emrahyalcin23/picolor/power_circuit.png

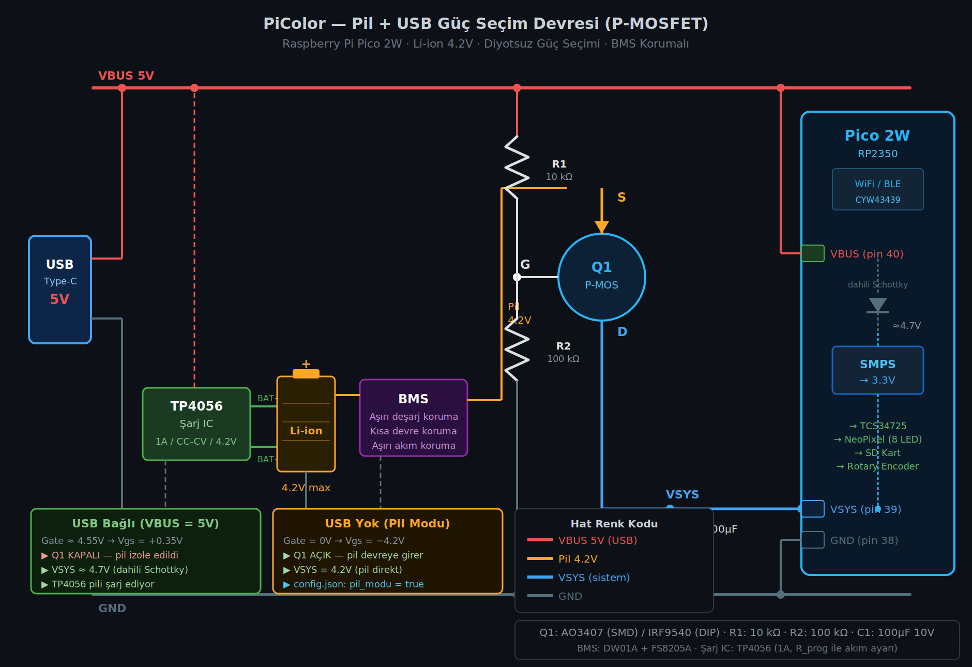
power_circuit.png
