emrahyalcin23/picolor/(commit log)

2026-05-14 feat: merkezi ondalık basamak ve Weber-Fechner logaritmik ölçek desteği
    İşlenmiş RGB çıktıları için `outputDecimals` değişkeni ile basamak sayısı
    merkezi olarak kontrol edilebilir hale getirildi (varsayılan: 1, geriye
    uyumlu). `applyOutputScale()` ile Weber-Fechner (fotometrik standart)
    logaritmik dönüşüm eklendi; bu dönüşüm varsayılan olarak kapalıdır.
    Yeni komutlar:
    - BASAMAK_<n> : ondalık basamak (0–6)
    - LOGARITMIK : log ölçeği aç (mevcut dekad)
    - LOGARITMIK_<n> : log ölçeği aç + dekad ayarla (1.0–5.0)
    - LINEER : lineer ölçeğe dön
    - VARSAYILAN/DEFAULT: fabrika ayarlarına dön (decimals=1, lineer)
    - OLCEK/SCALE : me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
2026-05-14 fix: RP2040 SPI.begin() API uyumsuzluğunu düzelt
    ESP32 tarzı SPI.begin(sck, miso, mosi, cs) çağrısı RP2040'ta desteklenmiyor.
    RP2040'ın SPIClassRP2040 API'sine uygun setRX/setTX/setSCK/setCS + begin()
    sırasına geçildi.
    https://claude.ai/code/session_01SwauKkrZt6LshzN8axL5hw
    [PiColor.ino]
2026-05-27 feat(d6): WiFi AP+STA + TCP soketi + BLE NUS kablosuz katmanı
    - WIRELESS_ENABLED / LOGGING_ENABLED özellik anahtarları eklendi
    - broadcastLine() ile tüm çıktılar Serial+TCP+BLE'ye çoğaltılır;
    Serial satırı değişmez, wireless satıra ;user=<username> eklenir
    - processCommandLine(line, username) ile TCP/BLE komut ayrıştırması
    handleSerialCommands() ile ortak kod yolu paylaşır
    - setupWiFi(): AP(PiColor) + STA dual mod, TCP:8266, picolor.local mDNS
    - setupBLE(): ArduinoBLE ile NUS (6E400001) servisi, TX notify + RX write
    - handleTCPClients() / handleBLEClients(): non-blocking loop entegrasyonu
    - USER:username prefix ile şifresiz kimlik etiketi desteği
    - WIRELESS_ENABLE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
2026-06-04 BLE katmanını ArduinoBLE'den BTstackLib'e geçir (Pico 2W uyumu)
    ArduinoBLE, Pico W/2W'nin CYW43439 yongasını desteklemiyor; arduino-pico
    core'un built-in BTstackLib'i ile değiştirildi. NUS UUID'leri, komut
    mantığı ve diğer tüm iletişim kanalları (WiFi, TCP, Serial) değişmedi.
    Bağlantı/bağlantı-kesme callback tabanlı; RX yazma olayları ana döngüden
    işleniyor (BTstack reentrancy sorunundan kaçınmak için).
    https://claude.ai/code/session_01VbD8HC3pcwUNz6DdSRJpcG
2026-06-16 Özellik anahtarlarını config.h'e, runtime ayarları SD config.txt'e taşı
    - config.h: WIRELESS_ENABLED, LOGGING_ENABLED derleme bayrakları +
    DEFAULT_* sabitleri + EEPROM flash yazma limiti uyarısı
    - config.txt: SD kartta kullanıcının düzenleyeceği key=value dosyası
    - PiColor.ino: loadSDConfig() boot'ta SD'den okur; kart/dosya yoksa
    DEFAULT_* değerleri korunur
    - WiFiServer pointer'a alındı (cfgTcpPort runtime'da belirleniyor)
    - WIFI_AP_SSID/PASS/TCP_PORT/LOG_FILE #define'ları cfg* değişkenleriyle değiştirildi
    https://claude.ai/code/session_01U3DkBfnZt8ahWiA8Nv8KkM
    [config.txt]
2026-06-16 Başlangıç koşullarını config.txt'den yükle, EEPROM uyarısını .ino'ya ekle
    - loadSDConfig(): basamak, logaritmik, log_dekad, mod, dual_cikti
    anahtarları eklendi — outputDecimals, logarithmicOutput, logDecades,
    calibMode, dualOutputActive boot'ta config'den okunur
    - EEPROM flash yazma limiti uyarısı EEPROM tanımlarının üstüne eklendi
    - config.txt yeni anahtarları ve açıklamalarını içerecek şekilde güncellendi
    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
    [config.txt]
2026-06-16 config.txt: her ayar için detaylı Türkçe açıklama ekle
    Weber-Fechner formülünün normal log'dan farkı, logaritmik mod,
    log_dekad oranları, STABIL/DINAMIK mod farkı açıklandı
    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
    [config.txt]
2026-06-16 platformio.ini ekle: PlatformIO için BT stack ve kütüphane ayarları
    Arduino IDE platformio.ini'yi yok sayar — iki araç birbirini etkilemez.
    PlatformIO'da ip_bluetooth_stack otomatik uygulanır, elle ayar gerekmez.
    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
2026-06-16 platformio.ini: platform, core ve kütüphane versiyonlarını kilitle
    - platform: maxgerhardt/platform-raspberrypi#v1.13.0 (tag sabitlendi)
    - platform_packages: arduino-pico core 3.9.4 (ikinci katman kilitleme)
    - lib_deps: ^ kaldırıldı, tam sürüm numaraları kullanıldı
    - Tekrarlanabilir build için politika yorumu eklendi
    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
2026-06-16 BLE API'yi BTstackLib yeni versiyonuyla uyumlu hale getir
    - BD_ADDR bleCentralAddr → hci_con_handle_t bleCentralHandle
    - device->getAddress() → device->getHandle()
    - BTstack.bleStartAdvertising() → BTstack.startAdvertising() (2 yerde)
    - onBLECharacteristicWrite: void(BLEDevice*,int,...) → int(uint16_t,...)
    - BTstack.sendNotification() → att_server_notify() (att_server.h eklendi)
    - Bağlantı kopunca bleCentralHandle HCI_CON_HANDLE_INVALID'e sıfırlanır
    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
2026-06-16 platformio.ini: arduino-pico core versiyonunu 5.6.0 olarak güncelle
    Derleme başarıyla doğrulandı: rp2040 5.6.0 ile BTstackLib
    yeni API'si (getHandle, startAdvertising, att_server_notify) çalışıyor.
    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
2026-06-16 DURUM komutu ekle, TCP sunucu timing sorununu düzelt
    - showDurum(): versiyon, SD, ölçek ayarları, WiFi AP IP/port, BLE durumu
    - DURUM / STATUS komutu processCommand ve YARDIM ekranına eklendi
    - softAP() sonrası IP atanana kadar bekle — TCP begin() öncesi timing fix
    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
    [PiColor.ino]
2026-06-16 WiFiServer pointer → global static, TCP bağlantı sorunu düzelt
    new WiFiServer() heap allocasyonu arduino-pico 5.6.0'da begin() ile
    çalışmıyor. Global static + begin(port) yaklaşımına dönüldü.
    Versiyon v0.06.04 → v0.06.05
    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
2026-06-16 TCP port compile-time sabite dönüştür, WiFiServer global static'e al
    WiFiServer(0).begin(port) arduino-pico 5.6.0'da çalışmıyor — port
    0 ile bağlanıp 8266'yı dinlemiyor. WiFiServer(DEFAULT_TCP_PORT) global
    static olarak tanımlandı, begin() parametresiz çağrılıyor.
    cfgTcpPort değişkeni ve tcp_port config okuma kaldırıldı.
    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
    [config.txt]
2026-06-16 feat(wifi): AP+STA çift mod — ev ağı entegrasyonu (v0.07.00)
    - setupWiFi: AP önce başlatılıyor, STA non-blocking sonra bağlanıyor
    (önceki sıra bazen AP'yi engelleyebiliyordu)
    - reconnectWiFiSTA: WiFi.disconnect() kaldırıldı — AP'yi kesmiyoruz
    - handleWiFiReconnect: loop'ta her 30s STA bağlantısını kontrol eder,
    kopmuşsa otomatik yeniden bağlanır
    - DURUM/STATUS: STA_IP satırı eklendi (ev ağı IP'si görünür hale geldi)
    - WIFI_BILGI: STA_IP ve AP_IP ayrı ayrı raporlanıyor
    - TCP sunucusu AP (192.168.42.1) ve STA (ev ağı IP) her ikisinde dinler
    Kullanım:
    WIFI_SSID=<ev_agi_adi> → EEPROM'a yaz
    WIFI_PASS=<sifre> → EEPROM'a yaz
    WIFI_BAGLAN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
2026-06-16 fix(config): SD karttan STA kimlik bilgisi okuma + öncelik sırası düzeltmesi (v0.07.01)
    Sorun: STA kimlik bilgileri yalnızca EEPROM'a yazılabiliyordu; her reset
    sonrasında Serial Monitor bağlantısı gerekliydi. config.txt'e wifi_sta_ssid /
    wifi_sta_pass eklenerek SD kart üzerinden dağıtım yapılabilir hale geldi.
    Sorun: setup() içinde loadSDConfig() EEPROM'dan ÖNCE çalışıyordu; bu yüzden
    EEPROM her zaman SD'yi eziyordu. Sıra düzeltildi:
    1. loadWiFiCredentials() — EEPROM (düşük öncelik)
    2. loadSDConfig() — SD kart (yüksek öncelik, EEPROM'u geçersiz kılar)
    Değişiklikler:
    - loadSDConfig(): wifi_sta_ssid / wifi_sta_pass anahtarları eklendi
    (y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
    [config.txt]
2026-06-16 feat(wifi): STA otomatik bağlantı bayrağı — DEFAULT_WIFI_STA_AUTO (v0.08.01)
    config.h: DEFAULT_WIFI_STA_AUTO = true (açılışta otomatik STA bağlantısı)
    config.txt: wifi_sta_otomatik=true/false anahtarı eklendi
    PiColor.ino: cfgWifiStaAuto değişkeni; setupWiFi ve handleWiFiReconnect
    bu bayrağı kontrol ediyor — false ise yalnızca WIFI_STA_BAGLAN ile bağlanır
    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
    [config.txt]
2026-06-16 refactor(config): config.h sadeleştirildi, varsayılanlar .ino'ya taşındı (v0.08.02)
    config.h artık yalnızca derleme zamanı sabitleri içeriyor (4 satır):
    WIRELESS_ENABLED, LOGGING_ENABLED, MAX_TCP_CLIENTS, DEFAULT_TCP_PORT
    DEFAULT_WIFI_AP_SSID / PASS / STA_AUTO / LOG_FILE kaldırıldı;
    değerleri PiColor.ino içinde cfgWifiApSSID vb. başlangıç değerleri olarak taşındı.
    Kullanıcı yalnızca config.txt'e bakması yeterli; config.h nadiren değişir.
    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
2026-06-16 refactor: JSON config, WiFiServer pointer, #if guardları kaldırıldı (v0.09.00)
    [config.txt]
2026-06-16 fix: STA_IP display bug, TCP_PORT= runtime komutu, changeTcpPort() (v0.09.01)
    - showDurum(): strlen(wifiStaSSID) > 0 kontrolü eklendi — SSID boşken
    WiFi.status()==WL_CONNECTED yanlış pozitif veriyordu (CYW43 AP mode quirk)
    - changeTcpPort(): stop→delete→new→begin döngüsüyle runtime port değişimi
    - processCommandLine(): TCP_PORT=<n> komutu eklendi
    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
    [PiColor.ino]
2026-06-16 fix(tcp): WiFiServer global nesne kullan — begin() arduino-pico'da güvenilir çalışsın (v0.09.02)
    new WiFiServer() heap alloc + begin() arduino-pico 5.6.0'da tcp listener
    oluşturmuyor (actively refused). Standart pattern: global nesne + begin().
    - g_tcpServer(DEFAULT_TCP_PORT) global eklendi
    - setupWiFi(): &g_tcpServer ile başlat, cfgTcpPort farklıysa changeTcpPort()
    - changeTcpPort(): global vs heap ayrımı — global nesneyi delete etme
    - #define DEFAULT_TCP_PORT 8266 eklendi (config.h silindikten sonra eksikti)
    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
    [PiColor.ino]
2026-06-16 feat: WIRELESS_ENABLED komutu, LittleFS config.json desteği (v0.09.03)
    - WIRELESS_ENABLED=0/1 (veya OFF/ON, FALSE/TRUE): oturum bazlı WiFi
    açma/kapama; disableWiFi() + enableWiFi() fonksiyonları eklendi
    - LittleFS desteği: SD kart yoksa Pico kendi flash'ından /config.json okur
    Öncelik: SD kart > LittleFS > hardcoded default
    - data/config.json: "Upload Filesystem Image" ile LittleFS'e yazılacak şablon
    - platformio.ini: board_build.filesystem_size = 256k eklendi
    - handleTCPClients / handleWiFiReconnect: !wifiEnabled guard eklendi
    - setupWiFi: MDNS.begin() çift çağrıya karşı static flag koruması
    - Versiyon v0.09.03
    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
2026-06-16 chore: platformio.ini kaldırıldı — proje Arduino IDE ile yönetilecek
    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
2026-06-16 fix: DEFAULT_WIFI_STA_SSID/PASS eklendi — ev modemi bilgisi en tepede görünür
    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
    [PiColor.ino]
2026-06-16 fix: loadWiFiCredentials — EEPROM boşsa default değeri silme
    EEPROM'da kayıt yokken wifiStaSSID[0]='\0' yapılıyordu, DEFAULT_WIFI_STA_SSID
    değeri yok sayılıyordu. Artık EEPROM boşsa default korunuyor.
    Öncelik sırası: config.json (SD) > EEPROM > DEFAULT_WIFI_STA_SSID (.ino)
    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
    [PiColor.ino]
2026-06-16 fix: WIFI_STA_SIFIRLA anında default'a döner ve bağlanmayı dener
    clearWiFiCredentials(): EEPROM silindikten sonra wifiStaSSID/Pass'ı
    DEFAULT_WIFI_STA_SSID/PASS ile restore et, ardından reconnectWiFiSTA()
    ile hemen bağlantı denemesi başlat. DEFAULT boşsa NO_CREDENTIALS döner.
    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
    [PiColor.ino]
2026-06-16 fix: softAPConfig kaldırıldı — CYW43 5.6.0'da AP IP'siz kalıyordu
    softAPConfig(192.168.42.1) arduino-pico 5.6.0 CYW43 driver'ında
    uygulanmıyor, AP_IP=(IP unset) sonucunu veriyordu. Kaldırıldı;
    AP default 192.168.4.1 kullanır.
    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
    [PiColor.ino]
2026-06-16 fix: AP_IP display fallback + TCP_CLIENT_CONNECTED user=tcp (v0.09.04)
    - apIPStr(): softAPIP() 0.0.0.0 dönerse 192.168.4.1 göster (CYW43 quirk)
    - TCP bağlantı anında currentUsername="tcp" — user=serial yerine user=tcp
    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
    [PiColor.ino]
2026-06-16 revert: apIPStr() kaldırıldı — WIRELESS_ENABLED=0 durumunda yanlış IP gösteriyordu
    AP durduğunda softAPIP() 0.0.0.0 dönmesi doğru davranış.
    Hardcoded fallback yanıltıcıydı.
    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
    [PiColor.ino]
2026-06-17 test: --all bayrağı ve DURUM'dan otomatik IP keşfi eklendi
    - --all: Serial → WiFi → BLE sırasıyla tüm kanalları çalıştırır
    - --ip verilmezse Serial bağlantısı üzerinden WIFI_BILGI/DURUM
    sorgulanarak AP IP otomatik çekilir; bulunamazsa 192.168.42.1 kullanılır
    - ip_from_durum(): AP IP öncelikli, STA IP yedek, genel IPv4 son çare
    - WiFi bağlantı çıktısında IP'nin kaynağı gösterilir (--ip / DURUM / varsayılan)
    Claude-Session: https://claude.ai/code/session_01H9rqM9a2WAjiGBZZuHZdFa
2026-06-17 docs: README baştan yeniden yazıldı (v0.09.04)
    Eski README güncel değildi (yanlış NORM_INPUT_MAX, WiFi/BLE yok).
    Yeni README:
    - AP+STA çift mod WiFi, mDNS, TCP port yapılandırması
    - BLE Nordic UART Service UUID'leri
    - Çıktı protokolü tam tip/mod tablosu, DUAL format
    - STABIL/DINAMIK kalibrasyon formülleri ve encoder kullanımı
    - Weber-Fechner log ölçeği açıklaması
    - config.json öncelik sırası + EEPROM + derleme sabitleri
    - Tam komut referansı (tüm kategoriler)
    - RAM tamponu ve SD kart depolama detayları
    - EN + TR tam çift dil
    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
2026-06-17 fix: prevent Serial.println() from blocking when no USB host is connected
    Without a USB host (e.g. 5V charger), the CDC TX buffer fills up and
    Serial.println() blocks indefinitely, freezing the main loop and making
    the encoder and LEDs unresponsive. Guard the call with `if (Serial)`.
    Claude-Session: https://claude.ai/code/session_01MzXoiq43XPTvuBu1bNvTpt
    [PiColor.ino]
2026-06-18 fix: use availableForWrite() guard and Serial host check to prevent USB CDC blocking
    Two changes:
    1. broadcastLine(): replace `if (Serial)` with `availableForWrite()` check — works
    across all arduino-pico versions regardless of how operator bool() is implemented.
    When no USB host is present the CDC TX buffer fills and never drains; checking
    available space before writing prevents the infinite busy-wait inside Serial.write().
    2. handleSerialCommands(): add `!Serial` guard before readStringUntil() — some chargers
    drive D+/D- lines (Apple charging spec) which can trigger spurious Serial.available()
    reads; without a host check this causes a 1-second timeout per loop iteration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
    [PiColor.ino]
2026-06-18 fix: move Serial.begin() after setupWiFi/BLE to prevent CYW43 init failure
    Root cause: Serial.begin() starts TinyUSB which, with no USB host connected
    (5V charger), enters a continuous attach-retry loop generating high-frequency
    USB IRQs. These IRQs interfere with the CYW43439 SPI initialization, causing
    WiFi.softAP() to fail silently and the while(softAPIP()==0) guard loop to
    spin forever. setup() never completes, loop() never starts.
    Fix: initialize CYW43 (WiFi + BLE) before starting USB Serial so the chip
    comes up cleanly regardless of whether a USB host is present.
    Claude-Session: https://claude.ai/code/session_01MzXoiq43XPTvuBu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
    [PiColor.ino]
2026-06-18 debug: add TCS LED blink markers throughout setup() to find hang point
    Blink count indicates last completed step before device freezes.
    Remove dbgBlink() calls once root cause is identified.
    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
2026-06-18 fix: move Serial.begin() after WiFi/BLE init to prevent charger boot hang
    Root cause (confirmed via LED blink diagnostics): arduino-pico's USB CDC
    stack blocks inside Serial.begin() until a USB host enumerates the device.
    With a 5V charger (no USB host) this wait is infinite — setup() never
    completes, WiFi AP never starts, encoder never responds.
    Fix: remove Serial.begin() from the top of setup(). Call it only after
    setupWiFi() and setupBLE() have already succeeded. Add a 3-second timeout
    so the USB wait does not block indefinitely when no host is present.
    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
    [PiColor.ino]
2026-06-18 fix: add 15s timeout to softAPIP() busy-wait in setupWiFi and restartAP
    Without a timeout, setup() hangs forever if CYW43 takes too long or
    fails to assign the AP IP — blocking WiFi AP start on 5V charger.
    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
    [PiColor.ino]
2026-06-18 fix: skip STA connect when AP IP unset to prevent WiFi.begin() disrupting AP
    In arduino-pico 5.6.0, calling WiFi.begin() (STA) can interfere with
    an active softAP. Guard: only attempt STA connection when AP has a valid
    IP, ensuring the AP is fully up before STA is started.
    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
    [PiColor.ino]
2026-06-18 debug: NeoPixel renk markörleriyle setup() adım tanılaması
    Her adımda pixel-0 farklı renk — şarj başlığında takılı kaldığı
    yerde o renk sabit kalır. Test sonrası kaldırılacak.
    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
2026-06-18 debug: ham GPIO blink ile adım tanılaması (NeoPixel yok, sadece digitalWrite)
    N blink = N. adıma kadar ulaşıldı. 1 blink bile yoksa sorun
    framework init'te (setup() öncesi).
    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
2026-06-18 fix: serialReady flag ile Serial.begin() öncesi Serial erişimini engelle
    TinyUSB ile Serial.availableForWrite() Serial.begin() çağrılmadan
    önce bloke oluyordu. serialReady=false başlangıçta, Serial.begin()
    sonrasında true olur — broadcastLine() bu flag'i kontrol eder.
    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
    [PiColor.ino]
2026-06-18 debug: Wire.begin/tcs.begin arasina blink ekle, adim1=5 blink
    5 blink = setup() calisiyor (sensor farkindan ayirt eder).
    Wire.begin() sonrasi 2 blink, tcs.begin() sonrasi 3 blink.
    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
2026-06-18 fix: initVariant() override ile pre-setup() USB host beklemesini engelle
    arduino-pico weak tanimli initVariant()'i override ederek charger'da
    setup()'tan once gerceklesen USB host bekleme blogu kaldirildi.
    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
    [PiColor.ino]
2026-06-18 debug: global constructor probe (7 blinks) - main()/initVariant() oncesi
2026-06-18 debug: EarlyProbe duzeltme — RP2350 icin pico SDK gpio+timer kullan (busy_wait_ms)
2026-06-19 fix: No USB modu icin Serial guardi + serial_compat.h (USB-C sarj uyumlulugu)
    [PiColor.ino, serial_compat.h]
2026-06-19 fix: SerialUSBStub — No USB modunda SdFat linker hatalarini gider
    PioSdioCard.cpp (kullanilmayan SDIO surucu) Serial sembolune referans verir.
    No USB modunda SerialUSB derlenmediginden linker hata verir.
    Mangiled C++ sembolleri extern "C" ile stub olarak saglanir; char Serial[256]
    linker icin global nesneyi karsilar.
    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
    [SerialUSBStub.cpp]
2026-06-19 fix: cift sifirlama BOOTSEL'i devre disi birak (Apple 20W uyumlulugu)
    Apple 20W USB-C sarj basligi baglanti aninda VBUS'ta kisaca duser,
    RP2350 anlik sifirlanir. arduino-pico'nun cift-sifirlama=BOOTSEL ozelligi
    tetiklenince cihaz USB mass storage moduna girer, kullanici kodu
    hic calismaz. SKIP_DOUBLE_TAP bunu engeller.
    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
2026-06-19 refactor: debug kodu kaldir, NeoPixel boot LED ekle, RP2040→RP2350
    - _EarlyProbe ve _dbg() tamamen kaldırıldı
    - tcs.begin() hata/başarı mesajları geri eklendi
    - Boot tamamlanınca: R→G→B (3x100ms) blink
    - STA bağlanırken: kırmızı LED; bağlanınca: 1sn yeşil LED
    - RP2040 → RP2350 (PiColor.ino ve README.md)
    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
2026-06-19 docs: Arduino IDE ayarlarini ino basligina ekle
    Board, USB Stack (No USB), IP Stack (IPv4 Only), Flash Size,
    Upload Method ve Debug Level ayarlari aciklama ve gerekce ile
    belgelendi.
    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
2026-06-19 docs: IP Stack ayarini duzelt — IPv4+IPv6+Bluetooth
    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
2026-06-19 fix: STA kirmizi LED setupWiFi icinde WiFi.begin ile goster
    WiFi cok hizli baglandiginda RGB blink sirasinda zaten WL_CONNECTED
    oluyordu; kirmizi hic gorunmuyordu. WiFi.begin() ile ayni anda
    kirmizi LED yakilarak kullanicinin her durumda gorebilmesi saglandi.
    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
    [PiColor.ino]
2026-06-19 docs: add connection priority section and fix AP IP in README
    - Add 'Connection Channel Priority' section (EN + TR) with recommended
    order: WiFi AP → WiFi STA → BLE → COM
    - Note that COM/USB Serial is disabled in current No USB build and how
    to re-enable with TinyUSB; clarify Apple 20W issue is stack-agnostic
    - Add expected startup time note (~50-70 s) with LED indicator description
    - Fix AP IP in both EN and TR tables: 192.168.42.1 → 192.168.4.1
    (softAPConfig doesn't work in arduino-pico 5.6.0; AP always uses default)
    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
2026-06-19 fix: unify Serial init and correct TCS LED polarity
    - Move Serial.begin() to first line of setup() so all status messages
    in setupWiFi()/setupBLE() reach the serial port in both modes;
    only the 3 s USB CDC wait stays inside #if USE_TINYUSB
    - Set serialReady = true unconditionally after Serial.begin() —
    previously it was never set in No USB mode so UART output was silently
    dropped
    - Remove #if USE_TINYUSB guard from broadcastLine() — Serial now works
    the same way in both modes, no conditional needed
    - Fix TCS LED polarity bug: digitalWrite(TCS_LED_PIN, LOW) on an
    active-LOW pin turns the LED ON; change to HIGH so it is actually
    off at startup as the comment stated
    Co-Author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
    [PiColor.ino]
2026-06-20 fix: remove updateLEDs() from setup to prevent spurious 4-LED flash
    updateLEDs() with default coefficient wR=0 always lights exactly 4 LEDs
    (norm=0.5 → numLeds=4), which appeared between the WiFi state LEDs and
    the RGB boot blinks, obscuring the expected sequence. LED display
    belongs in loop(); setup() only needs handleDataSampling() to seed the
    history buffer.
    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
    [PiColor.ino]
2026-06-20 revert: restore updateLEDs() call in setup
    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
    [PiColor.ino]
2026-06-20 fix: revert TCS LED to LOW=off (pin is active-HIGH, not active-LOW)
    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
    [PiColor.ino]
2026-06-20 restore: TCS LED pin to original state (comment and value)
    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
2026-06-20 feat: blink red 3x and turn off when WiFi STA fails to connect in 30s
    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
    [PiColor.ino]
2026-06-20 feat: wifi status in all outputs + battery mode reconnect limit
    - Add getWifiStatusStr(): returns STA SSID, "CONN", or "AP"
    - broadcastLine() appends ;wifi=<status> to every output line
    - Add cfgPilModu (config.json: "pil_modu": true/false, default false)
    When true, STA reconnect stops after 3 failed attempts
    When false (default/USB/charger), reconnect continues indefinitely
    - Track staReconnectAttempts; reset to 0 on successful connection
    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
    [PiColor.ino]
2026-06-20 getWifiStatusStr: WiFi.SSID() boş dönerse wifiStaSSID fallback
    arduino-pico'da WiFi.SSID() WL_CONNECTED durumunda zaman zaman boş string
    döndürebilir; bu durumda yapılandırılmış SSID (wifiStaSSID) kullanılır.
    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
2026-06-20 Change WiFi SSID retrieval to use default device name
2026-06-20 updateLEDs: beyaz karışım kaldırıldı, saf renk parlaklık ölçeği
    Encoder ile katsayı ayarlarken renk soluk beyaza kaymıyordu;
    beyaz karışım (w) tamamen kaldırıldı. Artık koyu saf renk → parlak saf renk.
    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
2026-06-20 Donanım dokümantasyonu: P-MOSFET ile pil+USB güç seçim devresi şeması
    Pico 2W için diyotsuz güç yönetimi SVG şeması eklendi.
    R1(10kΩ)/R2(100kΩ) gate kontrolü ile USB varlığında pil otomatik
    izole edilir; BMS ve TP4056 şarj yolu bağımsız çalışır.
    Claude-Session: https://claude.ai/code/session_01Une7yRkosLnMUEXLJrP8vH
2026-06-20 Donanım dokümantasyonu: devre şeması PNG versiyonu eklendi
    power_circuit.svg'nin PNG dışa aktarımı (2x çözünürlük).
    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
2026-06-20 Pil ömrü test scripti eklendi (PowerShell)
    WiFi STA üzerinden TCP bağlanarak belirli aralıklarla sorgu yapan,
    CSV log kaydeden ve pil ömrünü hesaplayan PowerShell aracı.
    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
2026-06-20 picolor_pil_test.ps1: pure ASCII'ye donusturuldu
    PowerShell 5.1 UTF-8 BOM olmayan dosyalari ANSI olarak okudugu icin
    Unicode karakterler (kutu cizimleri, Turkce harfler) parse hatasina yol
    aciyordu. Tum non-ASCII karakterler ASCII esdegleriyle degistirildi.
    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
2026-06-20 fix: unwrap AggregateException in TCP connect to show real error
    Task.Wait() in PowerShell 5.1 throws AggregateException when the task
    faults, hiding the actual SocketException behind a generic message.
    Added an inner try/catch around Wait() that extracts InnerException so
    the real reason (DNS failure, connection refused, etc.) is shown instead.
    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
2026-06-20 fix: replace ConnectAsync/Wait with BeginConnect/WaitOne to avoid AggregateException
    Task.Wait() in PowerShell 5.1 surfaces faulted tasks as a
    MethodInvocationException wrapping AggregateException, making the real
    error (DNS failure, connection refused) invisible. BeginConnect +
    AsyncWaitHandle.WaitOne() has no such wrapping: EndConnect() throws
    the plain SocketException directly. Also drills InnerException chain
    in all catch blocks so the real message is always shown.
    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
2026-06-20 fix: resolve .local hostname via Resolve-DnsName before TCP connect
    .NET Framework's DNS resolver bypasses mDNS, so TcpClient.BeginConnect
    with a .local hostname always fails with "No such host is known" even
    when PuTTY works. Resolve-DnsName uses the Windows DNS Client service
    which supports mDNS, so resolve once at startup and pass the IP to
    BeginConnect for all subsequent queries.
    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
2026-06-20 fix: discard device greeting before sending command; add DURUM on first query; default OKU_1
    PiColor sends a TCP_CONNECTED greeting line immediately on connect.
    The script was reading that greeting as the command response, so the
    actual OKU/DURUM reply was never seen. Now we drain the greeting
    (up to 600ms) before writing the command to the stream.
    Also: first query is always DURUM so WiFi field populates immediately,
    and default command changed from OKU_0 to OKU_1.
    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
2026-06-20 fix: drain both TCP greeting lines before sending command
    On connect, firmware sends two lines before processing any command:
    1. Direct to client: TCP_CONNECTED=PICOLOR_vX.XX (no wifi/user suffix)
    2. Broadcast via printStatusMessage: TCP_CLIENT_CONNECTED (with wifi/user)
    Previous code discarded only the first; now drains until 300ms of
    silence so both are consumed before the actual command is written.
    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
2026-06-20 debug: print all received lines (greeting + response) to console
    Shows [S1],[S2],... for each discarded greeting line and [Y] for the
    actual command response so we can verify what the device sends and
    whether the drain is working correctly.
    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
2026-06-21 feat: auto-discover PiColor via ARP scan when mDNS fails
    When the default picolor.local hostname can't be resolved via mDNS,
    Find-PiColorIP scans the ARP neighbor table (Get-NetNeighbor with
    arp -a fallback), connects to each candidate on port 8266 with a
    500ms timeout, and checks the greeting for TCP_CONNECTED=PICOLOR.
    The discovered IP is shown in green as Bulunan IP at startup.
    Running without -HostName now works as long as the device is on
    the same network and in the ARP cache.
    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
2026-06-21 fix: restrict ARP scan to private IP ranges only
    0.0.0.5 (and similar special/VPN addresses) were passing the filter
    and being falsely identified as PiColor. Now only RFC-1918 private
    ranges are scanned: 10.*, 192.168.*, 172.16-31.*. Also added Dinamik
    (Turkish Windows locale) to the arp -a regex fallback.
    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
2026-06-21 fix: use named function for private IP check; show scan candidates
    Replaced the scriptblock ($isPrivate) with a named function so the
    $Matches variable is not corrupted across Where-Object calls. Also
    broadened the arp -a regex to match any address type (not just dynamic)
    and prints the candidate list before scanning so false positives like
    0.0.0.5 are visible immediately.
    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
2026-06-21 fix: replace ARP scan with full subnet TCP port scan
    ARP cache only contains devices communicated with before; a fresh
    session misses the PiColor device. Now Get-NetIPAddress determines
    the local subnet(s), then 254 async BeginConnect calls are fired in
    parallel to port 8266. After 800ms the completed connections are
    inspected for the TCP_CONNECTED=PICOLOR greeting. Works regardless
    of ARP cache state or network discovery/sharing settings.
    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
2026-06-21 feat: add ping-based mDNS fallback before subnet scan
    Resolve-DnsName uses the DNS Client service which may not support mDNS
    on all configs. ping uses winsock getaddrinfo() -- the same path PuTTY
    uses -- which does support mDNS on Windows 10/11. Added ping as step 2
    in the resolution chain: DNS Client -> ping parse -> subnet scan.
    ping is fast (~100ms) and produces zero network load vs 254 TCP opens.
    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
2026-06-21 Fix WiFi hostname on reconnect; add battery test tool docs
    - Call WiFi.setHostname() before WiFi.begin() in reconnectWiFiSTA()
    and handleWiFiReconnect() so DHCP requests always carry the device
    hostname — fixes "bilinmiyor" in router's wireless client list
    - Add Battery Life Test Tool section to README.md (English + Turkish)
    documenting picolor_pil_test.ps1: quick start, parameters, device
    discovery logic, console output format, and CSV log column reference
    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
    [PiColor.ino]
2026-06-21 Use RFC-compliant WiFi hostname to fix router "unknown" display
    PiColor_Modul_1 contains underscores which violate RFC 1123 hostname
    rules (only letters, digits, hyphens allowed). Many home routers silently
    reject DHCP option 12 when it contains underscores and show "unknown"
    instead. Add a separate DEFAULT_WIFI_HOSTNAME "PiColor-Modul-1" define
    and use it in all WiFi.setHostname() calls. DEFAULT_DEVICE_NAME is
    unchanged — it continues to be used for BLE advertising and TCP output.
    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
    [PiColor.ino]
2026-06-21 Sanitize device name to RFC-compliant WiFi hostname at runtime
    Add sanitizeHostname(): converts UTF-8 extended/Turkish chars to ASCII
    base (ş->s, ğ->g, İ->I, ı->i, ü->u, ö->o, ç->c, etc.), replaces
    underscores and spaces with hyphens, strips remaining non-[A-Za-z0-9-]
    chars, falls back to "picolor" if result is empty. This means whatever
    device name is set (PiColor_Modul_1, Ürün_Şarj_2, ...) the DHCP
    hostname will always be valid and the router will display it correctly.
    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
    [PiColor.ino]
2026-06-21 Bypass WiFi.setHostname() — apply DHCP hostname via lwIP directly
    WiFi.setHostname() in dual AP+STA mode operates on the wrong netif.
    Fix: after STA gets an IP, call netif_set_hostname() + dhcp_renew()
    directly on netif_default so the router receives a DHCPREQUEST with
    option 12 (hostname). This is the lwIP-level approach that works
    regardless of the arduino-pico wrapper behavior.
    - Add #include <lwip/netif.h> and <lwip/dhcp.h>
    - Add applyDhcpHostname(): sets hostname on netif_default, calls
    dhcp_renew(), guarded by g_hostnameApplied flag
    - Call it at first WL_CONNECTED event and in the periodic 30s check
    - Reset g_hostnameApplied = false whenever WiFi.begin() is called so
    hostname is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
    [PiColor.ino]
2026-06-21 Fix lwIP IPv4 address check for dual-stack build
    RP2350 arduino-pico enables both IPv4 and IPv6, so ip_addr_t is a union
    and .addr does not exist directly. Use netif_ip4_addr() + ip4_addr_isany()
    which work correctly regardless of IPv6 being compiled in.
    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
    [PiColor.ino]
2026-06-21 Fix DHCP hostname: find STA netif by IP, force fresh negotiation
    netif_default is unreliable in dual AP+STA mode — it may point to the
    AP netif. Instead, match WiFi.localIP() against every netif via
    NETIF_FOREACH to locate the actual STA interface. Then call dhcp_stop()
    + dhcp_start() to trigger a fresh DHCP DISCOVER/REQUEST cycle; those
    packets carry option 12 (hostname) so the router updates its device list.
    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
    [PiColor.ino]
2026-06-21 Fix dangling pointer: use global buffer for lwIP hostname
    netif_set_hostname() stores only the pointer, it does not copy the string.
    Using a local char hn[64] caused a dangling pointer: the function would
    return and destroy hn, then lwIP would dereference it seconds later when
    building the async DHCP DISCOVER packet — reading garbage instead of the
    hostname. g_wifiHostname is a global static array, so the pointer remains
    valid for the lifetime of the program.
    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
    [PiColor.ino]
2026-06-21 Fix: STA netif hostname eksikliği — applyDhcpHostname içinde netif_set_hostname ekle
    applyHostnameBeforeBegin() WiFi.begin() öncesinde çalışır; STA netif henüz
    oluşturulmadığından NETIF_FOREACH onu bulamaz. STA netif WiFi.begin() sırasında
    oluşturulur ve hostname alanı NULL kalır — DHCP paketlerine option 12 girmez.
    Düzeltme: applyDhcpHostname() bağlantı kurulduktan sonra IP ile STA netif'i
    bulur, önce netif_set_hostname(sta, g_wifiHostname) ayarlar, ardından
    dhcp_renew(sta) ile modemin client tablosunu hostname dahil günceller.
    Tanı için #include <lwip/opt.h> ve LWIP_NETIF_HOSTNAME pragma message eklendi.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
    [PiColor.ino]
2026-06-21 Fix: dhcp_renew yerine dhcp_stop+start ile DISCOVER gönder; hostname önce kaydet
    Modemler cihaz adını çoğunlukla yalnızca ilk DHCPDISCOVER'dan okuyor;
    dhcp_renew() ile gönderilen DHCPREQUEST (renewal) yeterli değil.
    Düzeltmeler:
    1. applyDhcpHostname(): netif_set_hostname(sta) sonrası dhcp_renew yerine
    dhcp_stop + dhcp_start çağrısı — hostname içeren yeni DISCOVER gönderir.
    2. setupWiFi(): WiFi.setHostname() artık WiFi.softAP() öncesinde çağrılıyor.
    arduino-pico bu değeri saklayarak STA netifi kurulurken DHCP başlamadan
    önce uygular — bu sayede ilk DISCOVER da option 12 taşıyabilir.
    Claude-Ses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
    [PiColor.ino]
2026-06-21 Fix: normal modda da yeniden bağlantı limiti ekle (maks 10 deneme)
    cfgPilModu=false durumunda sınır yoktu — cihaz sonsuza kadar WiFi.begin()
    çağırıyordu. Her deneme g_hostnameApplied=false yaparak hostname uygulamasını
    sıfırlıyordu; bu nedenle hostname hiçbir zaman kalıcı oturtulamamıyordu.
    - Normal mod: maks 10 deneme (5 dk), pil mod: 3 deneme (değişmedi)
    - Limit dolunca WIFI_STA_RECONNECTING durur; WIFI_STA_BAGLAN ile yeniden başlatılabilir
    - ATTEMPT=x/y çıktısı ile kaçıncı denemede olduğu izlenebilir
    - reconnectWiFiSTA(): manuel bağlantıda staReconnectAttempts sıfırlanır
    Claude-Session: https:/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
    [PiColor.ino]
2026-06-22 Fix: softAP öncesinde WiFi.setHostname() çağrısını kaldır; AP IP olmasa da STA başlat
    WiFi.setHostname() CYW43 başlamadan çağrılınca AP IP atamasını bozuyordu.
    AP IP 15 saniye içinde gelmezse artık sadece WIFI_AP_IP_TIMEOUT logu basılıyor;
    STA bağlantısı bu durumda da başlatılıyor. Önceki kodda AP IP yokken WiFi.begin()
    hiç çağrılmıyordu — staLedConnecting=false kalıyor, applyDhcpHostname() LED
    yolundan tetiklenemiyordu.
    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
    [PiColor.ino]
2026-06-22 fix: set hostname AFTER dhcp_stop() to survive CYW43 callback reset
    dhcp_stop() internally calls netif_set_addr(0.0.0.0) which triggers the
    CYW43 IP-change callback that resets sta->hostname = NULL. Setting the
    hostname before dhcp_stop() meant it was always erased before dhcp_start()
    could include it in the DHCPDISCOVER (option 12). Reorder to:
    1. dhcp_stop() — callback runs, resets hostname (irrelevant now)
    2. netif_set_hostname() — set after callback, pointer survives
    3. dhcp_start() — DHCPDISCOVER sent with hostname in option 12
    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
    [PiColor.ino]
2026-06-22 feat: add BASLANGIC command to replay startup log messages
    Startup messages (WiFi, DHCP hostname, sensor init) appear only once at
    boot and are missed when TCP connection is established later. Add a ring
    buffer (20 slots x 96 chars) that captures these messages via
    logStartupMessage(), and a BASLANGIC / STARTUP command that replays
    them on demand — same pattern as the DURUM command.
    Logged messages: TCS_OK, NEOPIXEL_OK, ENCODER_IRQ_OK, WIFI_AP_STARTED,
    WIFI_STA_CONNECTING, DHCP_HN:SEARCH, DHCP_HN:APPLIED, SYSTEM_STARTED.
    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
    [PiColor.ino]
2026-06-22 fix: set DHCP hostname after WiFi.begin() to catch STA netif before DISCOVER
    Previous approach (dhcp_stop + dhcp_start) caused physical WiFi disconnect:
    dhcp_stop() calls netif_set_addr(0.0.0.0) which triggers the CYW43 IP-change
    callback, which drops the radio link. The subsequent dhcp_start() then sent
    DHCPDISCOVER on a disconnected interface — the packet never reached the router,
    explaining why the device kept showing "Bilinmeyen" despite DHCP_HN:APPLIED.
    New approach:
    - applyHostnameAfterBegin(): called immediately after every WiFi.begin() call.
    WiFi.begin() creates the STA netif synchronously; WiFi association is async
    and takes 100-1000 ms. In that window we set netif->hostname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
    [PiColor.ino]
2026-06-22 fix: DHCPDISCOVER option 12 eksikliği düzeltildi — router artık hostname gösterir
    softAP() sonrası _mode=WIFI_AP olduğunda WiFi.begin(), ESP8266 uyumluluk hack'i
    olan beginAP() yoluna giriyor ve LwipIntfDev::begin() hiç çağrılmıyordu.
    LwipIntfDev::begin() ise dhcp_start() öncesi _netif.hostname'i set eden tek yer;
    çağrılmadığında hostname=NULL → DHCPDISCOVER option 12 içermez → router "Bilinmeyen".
    applyHostnameBeforeBegin() içine WiFi.mode(WIFI_AP_STA) eklendi. Bu çağrı
    _mode=WIFI_AP_STA yapar, _beginInternal() doğru else dalına girer →
    _wifi.begin() → LwipIntfDev::begin() → _netif.hostname="PiColor-Modul-1" →
    DHCPDISCOVER option 12 → router cihazı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
    [PiColor.ino]
2026-06-22 fix: LWIP_DHCP_DISCOVER_ADD_HOSTNAME=1 — DHCPDISCOVER artık option 12 içerir
    Kök neden (ikinci katman): lwIP 2.2.0'da LWIP_DHCP_DISCOVER_ADD_HOSTNAME varsayılanı 0.
    Bu flag 0 iken, _netif.hostname doğru set edilse bile dhcp_discover() hiç option 12
    eklemez → DHCPDISCOVER hostname taşımaz → router "Bilinmeyen" gösterir.
    build.opt'a -DLWIP_DHCP_DISCOVER_ADD_HOSTNAME=1 eklendi. arduino-pico'da lwIP,
    libpico.a'ya derlenmez; app compile time'da derlenir (cores/rp2040/lwip README).
    build.opt flagları -include serial_compat.h ile kanıtlandığı üzere dhcp.c dahil
    tüm dosyalara ulaşır. Bu flag opt.h'daki #ifndef bloğundan önce tanımlanır → etkin.
    Önceki fix (v0.09.09,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
    [PiColor.ino]
2026-06-22 fix: mDNS hostname g_wifiHostname ile güncellendi + DHCP_DISC_HN diagnostic
    1. MDNS.begin("picolor") → MDNS.begin(g_wifiHostname): router mDNS
    üzerinden de "PiColor-Modul-1" olarak görmeli.
    2. Startup log'a DHCP_DISC_HN=1 veya DHCP_DISC_HN=0 eklendi.
    Bu değer derleme zamanında LWIP_DHCP_DISCOVER_ADD_HOSTNAME'in
    sketch'e ulaşıp ulaşmadığını gösterir:
    - DHCP_DISC_HN=1 → build.opt flag aktif, DISCOVER option 12 içeriyor
    - DHCP_DISC_HN=0 → flag ulaşmadı, sorun hâlâ devam eder
    Versiyon: v0.09.10 → v0.09.11
    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
    [PiColor.ino]
2026-06-22 docs: update README for v0.09.12 — version numbers and mDNS hostname
    - Version bumped to v0.09.12 throughout (EN + TR sections)
    - mDNS hostname updated from picolor.local to picolor-modul-1.local
    (firmware now uses g_wifiHostname = "PiColor-Modul-1" for MDNS.begin)
    - PowerShell script default HostName updated accordingly
    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
